mmzarif/accessories/README.md

# accessories
electronic fashion accessories
