mmzarif/accessories/butterfly-pin/stl/wings.stl

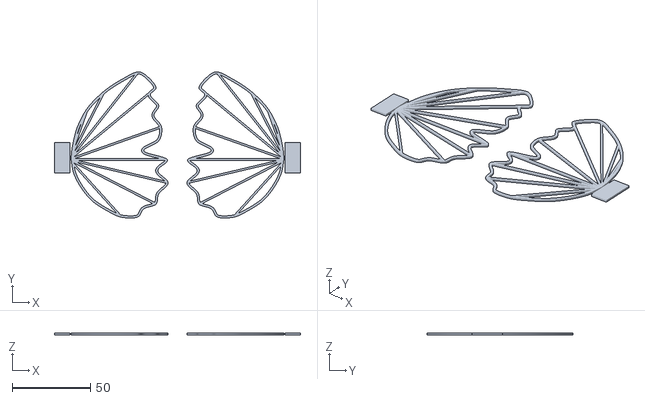
[picture p1: CAD file, 2026-09-20]
butterfly-pin/stl/wings.stl
157.0 x 93.3 x 1.20
