mmzarif/accessories/butterfly-pin/stl/pushrod.stl

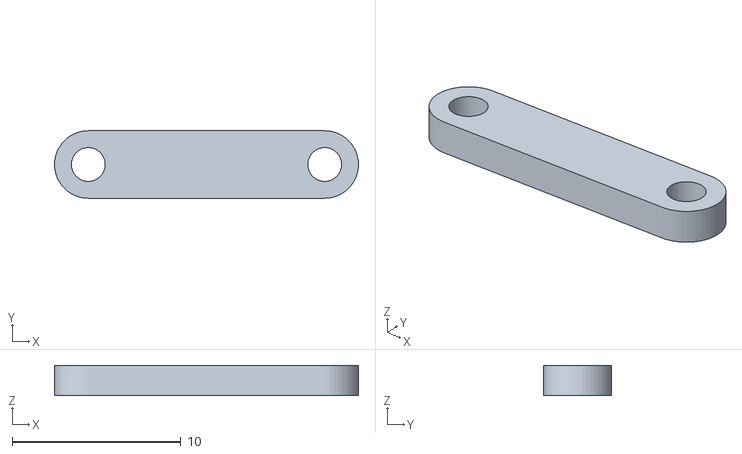
[picture p2: CAD file, 2026-09-20]
butterfly-pin/stl/pushrod.stl
18.0 x 4.00 x 1.80
