mmzarif/accessories/butterfly-pin/stl/tray.stl

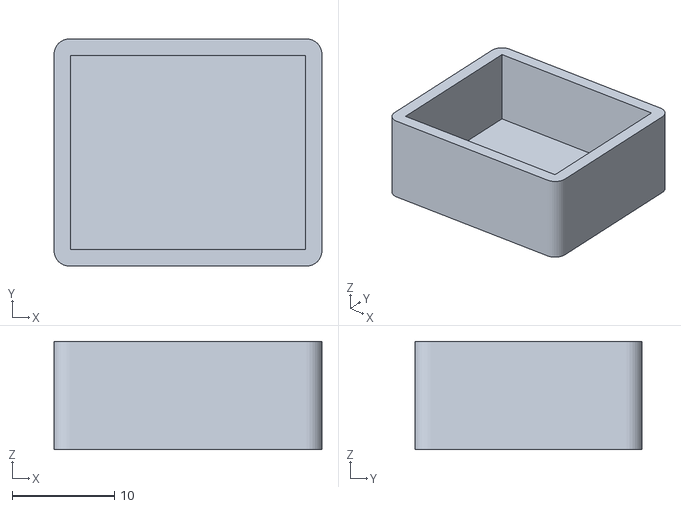
[picture p3: CAD file, 2026-09-20]
butterfly-pin/stl/tray.stl
26.2 x 22.2 x 10.6
