mmzarif/accessories/butterfly-pin/stl/rocker.stl

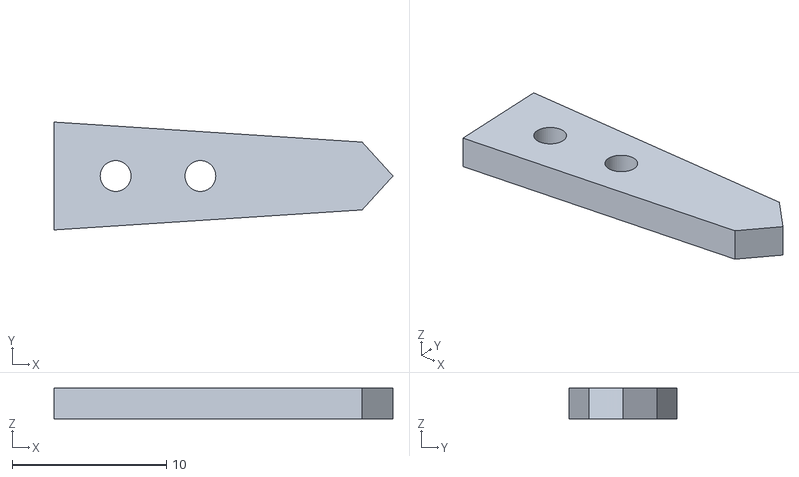
[picture p4: CAD file, 2026-09-20]
butterfly-pin/stl/rocker.stl
22.0 x 7.00 x 2.00
