mmzarif/accessories/butterfly-pin/stl/ALL_print_plate.stl

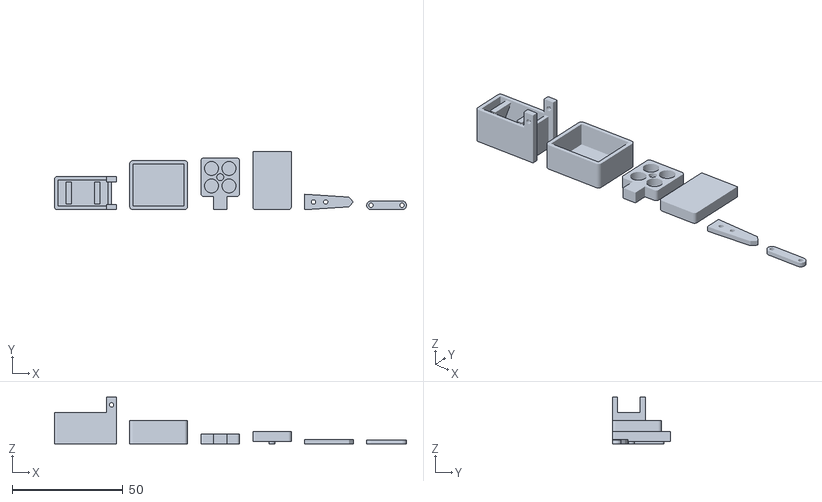
[picture p5: CAD file, 2026-09-20]
butterfly-pin/stl/ALL_print_plate.stl
158.9 x 26.4 x 21.1
