mmzarif/accessories/butterfly-pin/stl/wing_mount.stl

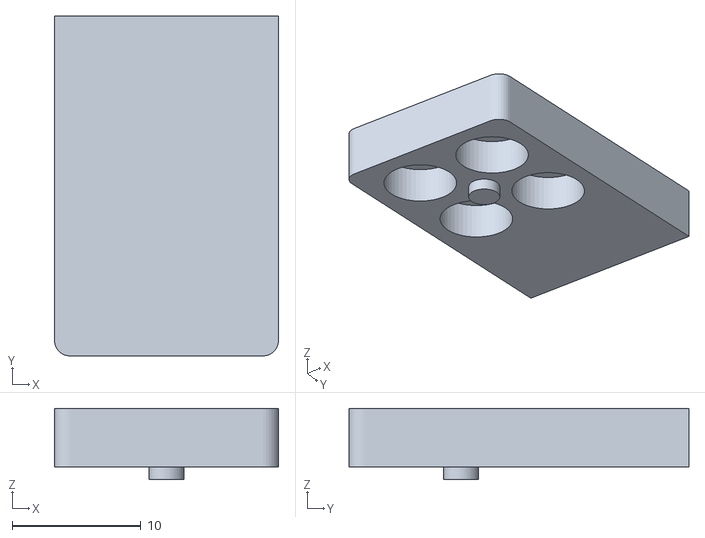
[picture p6: CAD file, 2026-09-20]
butterfly-pin/stl/wing_mount.stl
17.4 x 26.4 x 5.55
