mmzarif/accessories/butterfly-pin/stl/hinge_block.stl

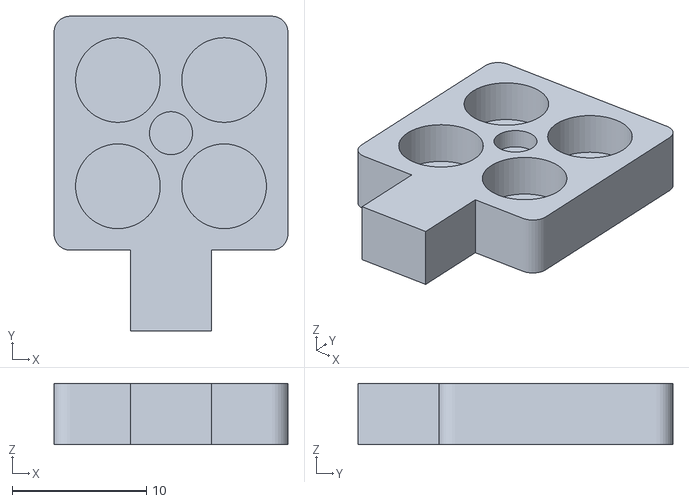
[picture p7: CAD file, 2026-09-20]
butterfly-pin/stl/hinge_block.stl
17.4 x 23.4 x 4.55
