mmzarif/accessories/butterfly-pin/stl/chassis.stl

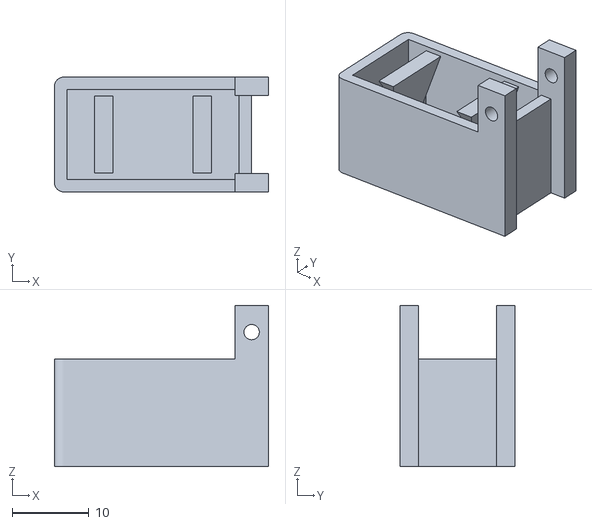
[picture p8: CAD file, 2026-09-20]
butterfly-pin/stl/chassis.stl
28.0 x 15.0 x 21.1
