mmzarif/accessories/(commit log)

2026-09-20 Add butterfly wing STL traced from the blue-morpho reference photo
    stl/wings.stl is a printable, filigree wing pair (rim + fanning veins,
    1.2 mm blade, scalloped hindwing, notch between fore/hind lobes) sized
    per docs/WINGS.md, with a bonding tab matching wing_mount.stl's bond
    face, laid out flat side-by-side for slicing. Generated reproducibly
    via cad/generate_wings.py (numpy/shapely/trimesh).
    Claude-Session: https://claude.ai/code/session_01GWJ5Hz4MFwBokV1GtsGBxB
    [wings.stl]
2026-09-20 Fix FeatureScript compile error: defineFeature took 2 arguments
    Onshape's defineFeature only accepts one argument (the feature
    function). The file passed a second, trailing map literal meant to
    set parameter defaults — that's not a valid form, and Onshape rejected
    it with "Function defineFeature with 2 argument(s) not found."
    Removed the dead second argument. Its length/integer/angle default
    values were already redundant with the bound specs' default entries
    (isLength/isInteger/isAngle take [min, default, max]) — except
    magClear and fitClear, which had shared one CLEARANCE_BOUNDS spec but
    wanted different defaults (0.15mm vs 0.25mm); split into
    MAG_CLEARANCE_BOUNDS and FIT_CLEARANCE_BOU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
